Francesco-Pagano/Agrometeorological-Station/v1_Pi4/img/Prototype.jpg

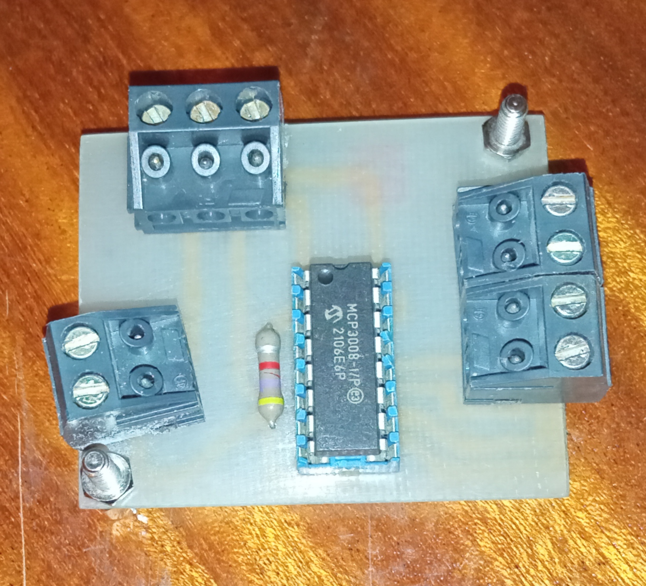
v1_Pi4/img/Prototype.jpg
