Francesco-Pagano/Agrometeorological-Station/v2_Pi0/img/Prototype.jpg

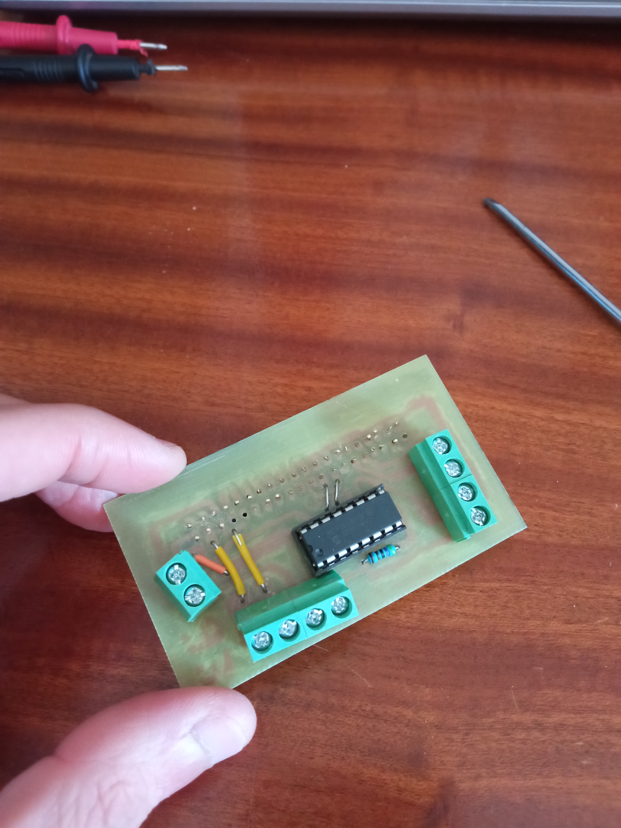
v2_Pi0/img/Prototype.jpg
