Francesco-Pagano/Agrometeorological-Station/v3_Heltec_v2/img/Power.png

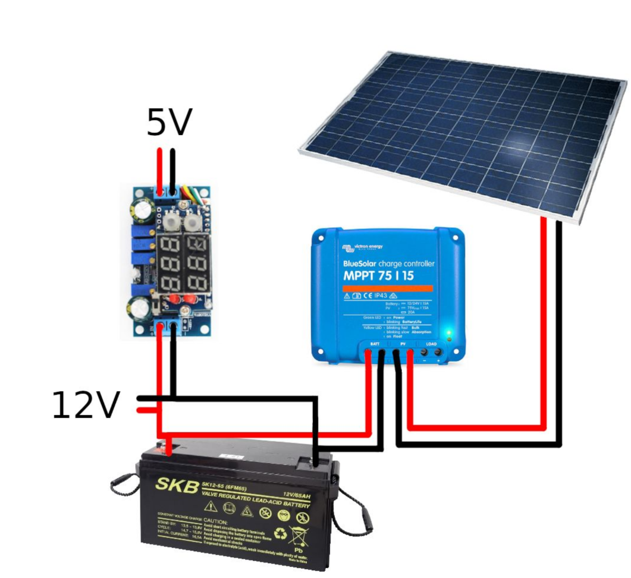
v3_Heltec_v2/img/Power.png
