Francesco-Pagano/Agrometeorological-Station/v4_ESP8266/Schematic_ESP8266_WS.pdf

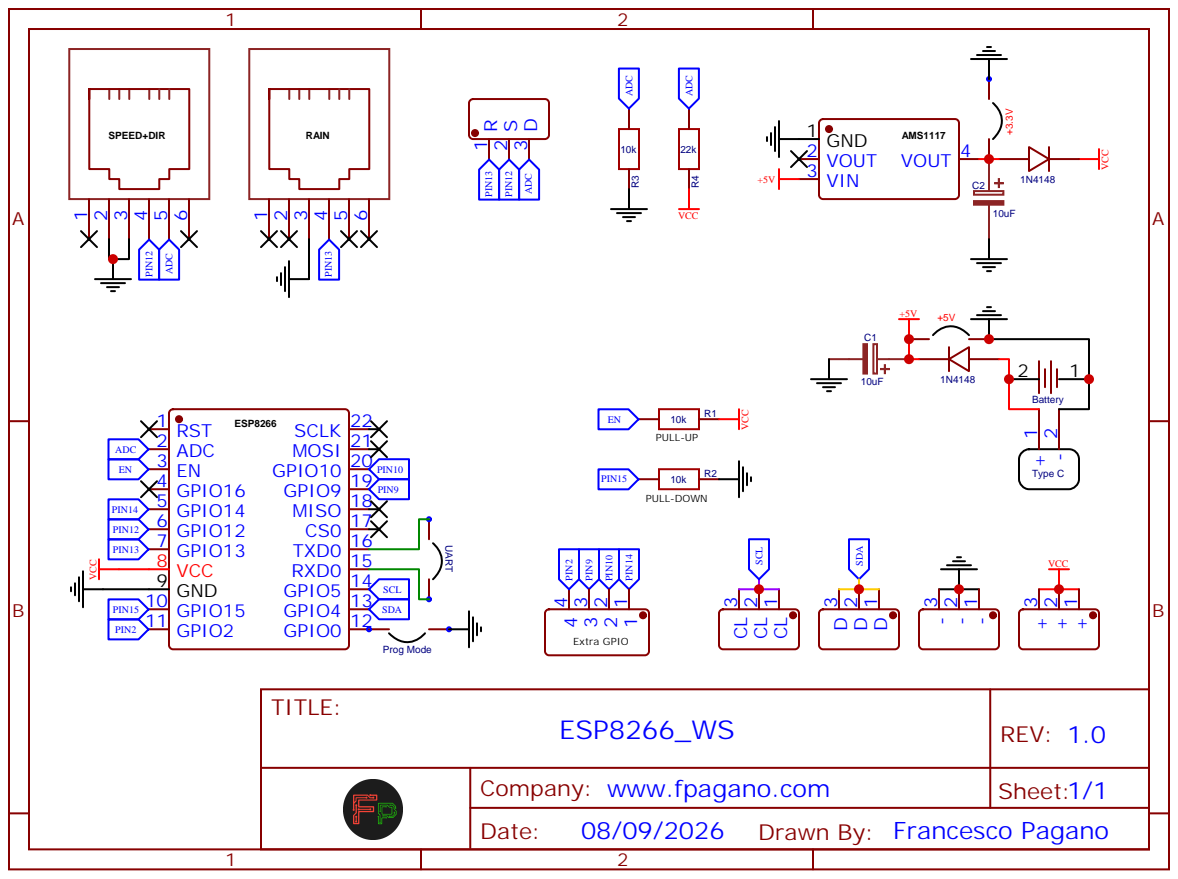
[picture p17: page 1]

Company: www.fpagano.com
