Francesco-Pagano/Agrometeorological-Station/v1_Pi4/Schematic_ShieldPi4_WS.pdf

# CH7 8 ⁵V

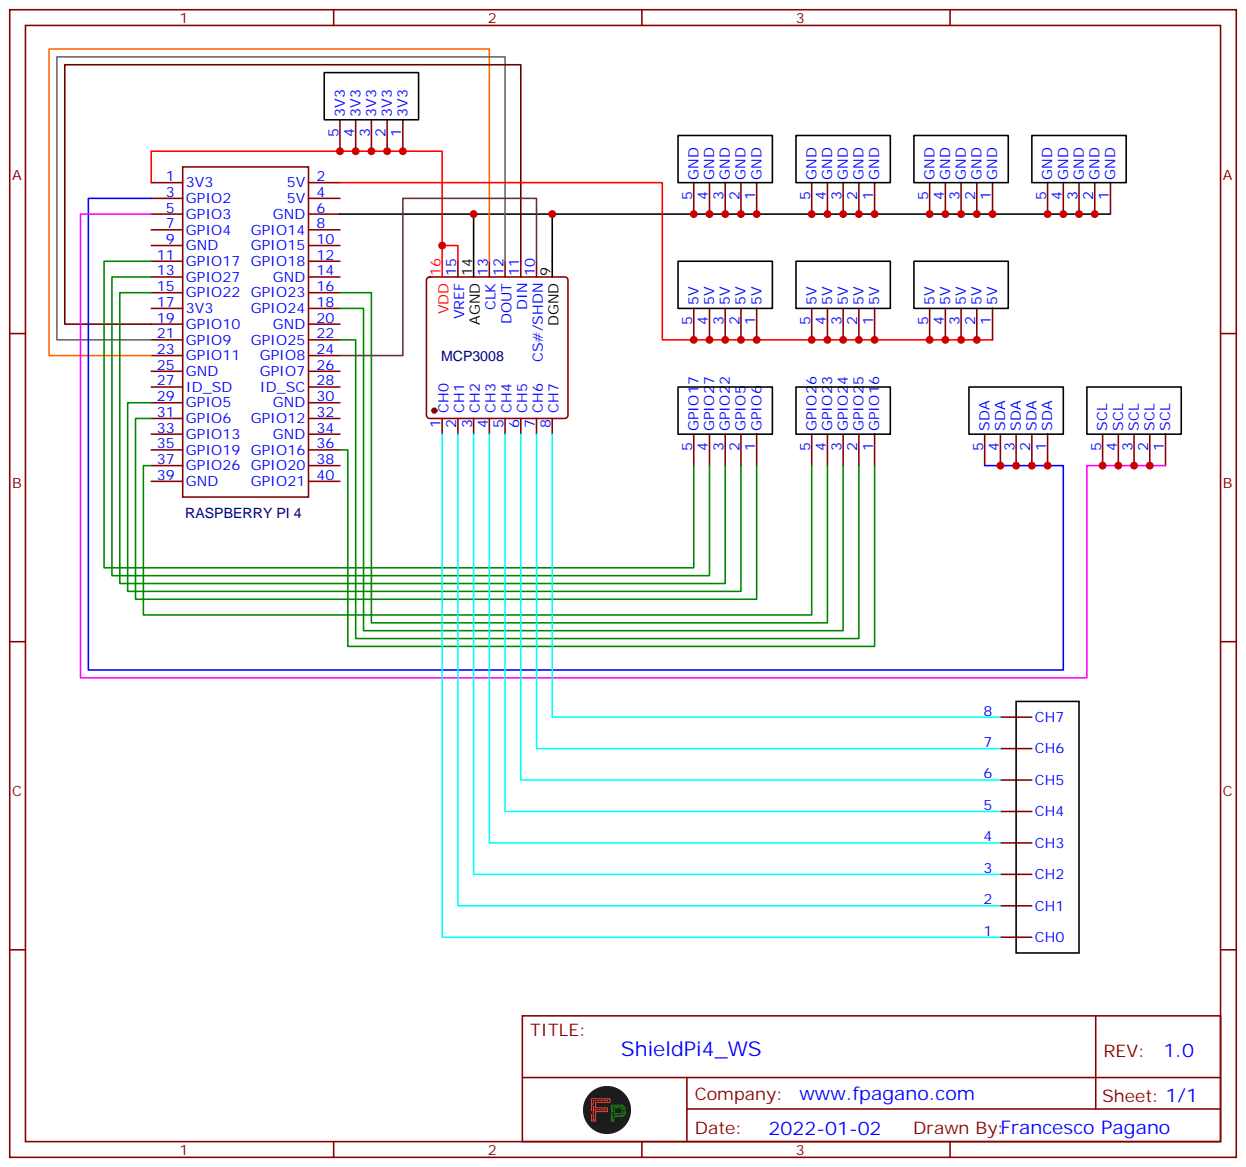
[picture p18: page 1]

9 CS#/SHDN 10 DIN 11 DOUT 12 CLK 13 AGND 14 VREF 15 VDD 16

Company: www.fpagano.com
