Francesco-Pagano/Agrometeorological-Station/v3_Heltec_v2/Schematic_ShieldHeltec_WS.pdf

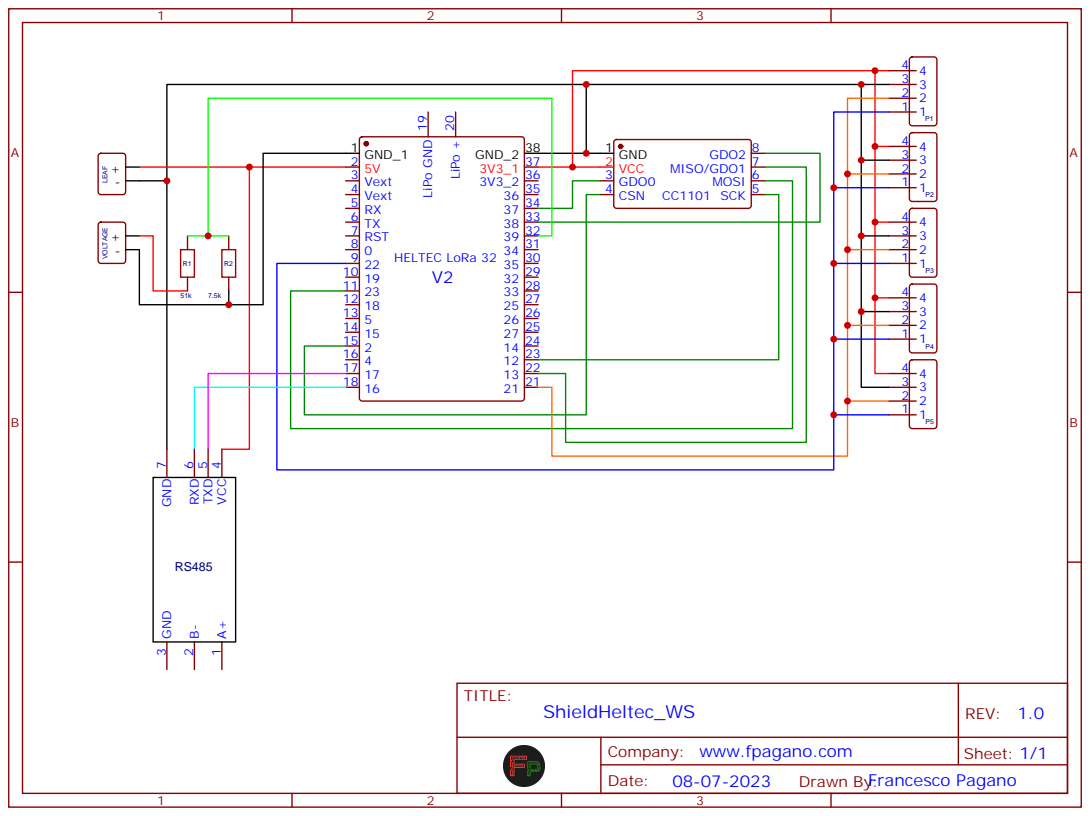
[picture p19: page 1]

Company: www.fpagano.com
