Francesco-Pagano/Agrometeorological-Station/v1_Pi4/PCB_PCB_ShieldPi4_WS.pdf

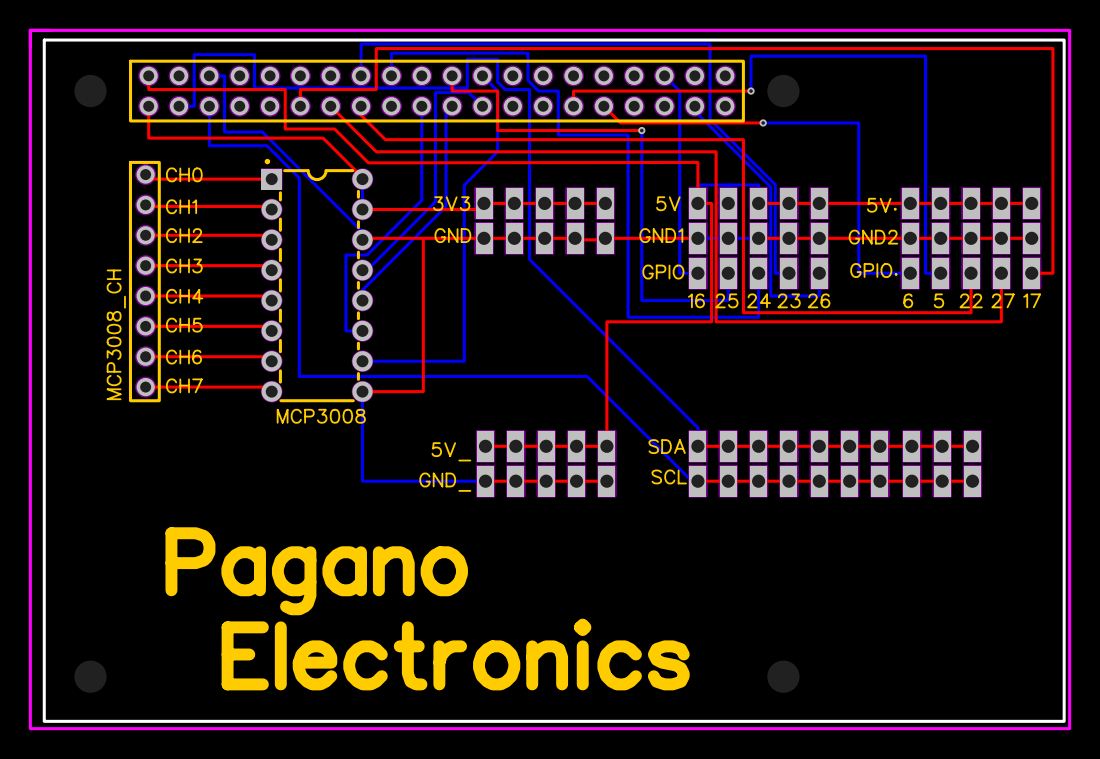
[picture p20: page 1]
