Francesco-Pagano/Agrometeorological-Station/v2_Pi0/PCB_PCB_ShieldPi0_WS.pdf

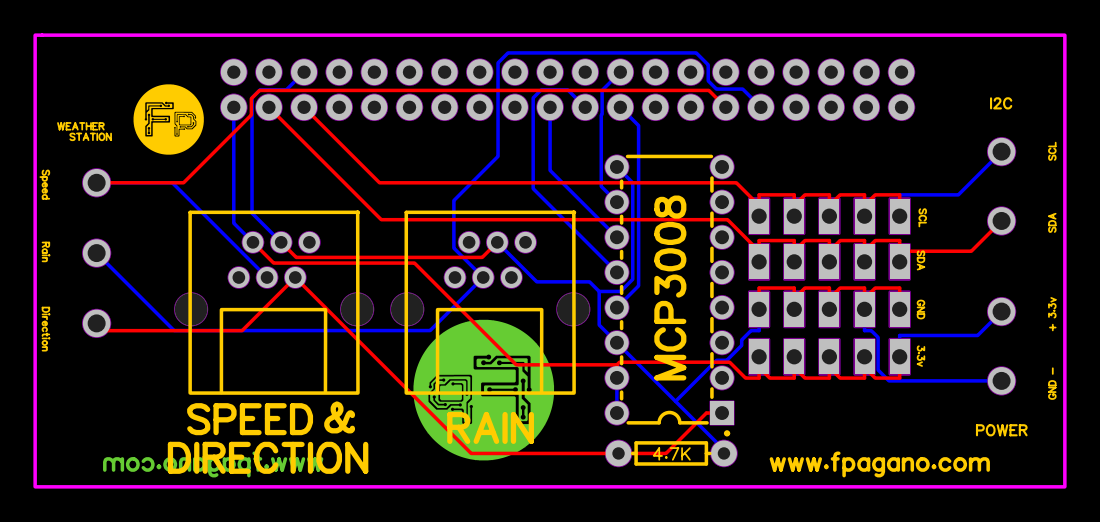
[picture p21: page 1]
