Francesco-Pagano/Agrometeorological-Station/v3_Heltec_v2/PCB_PCB_ShieldHeltec_WS.pdf

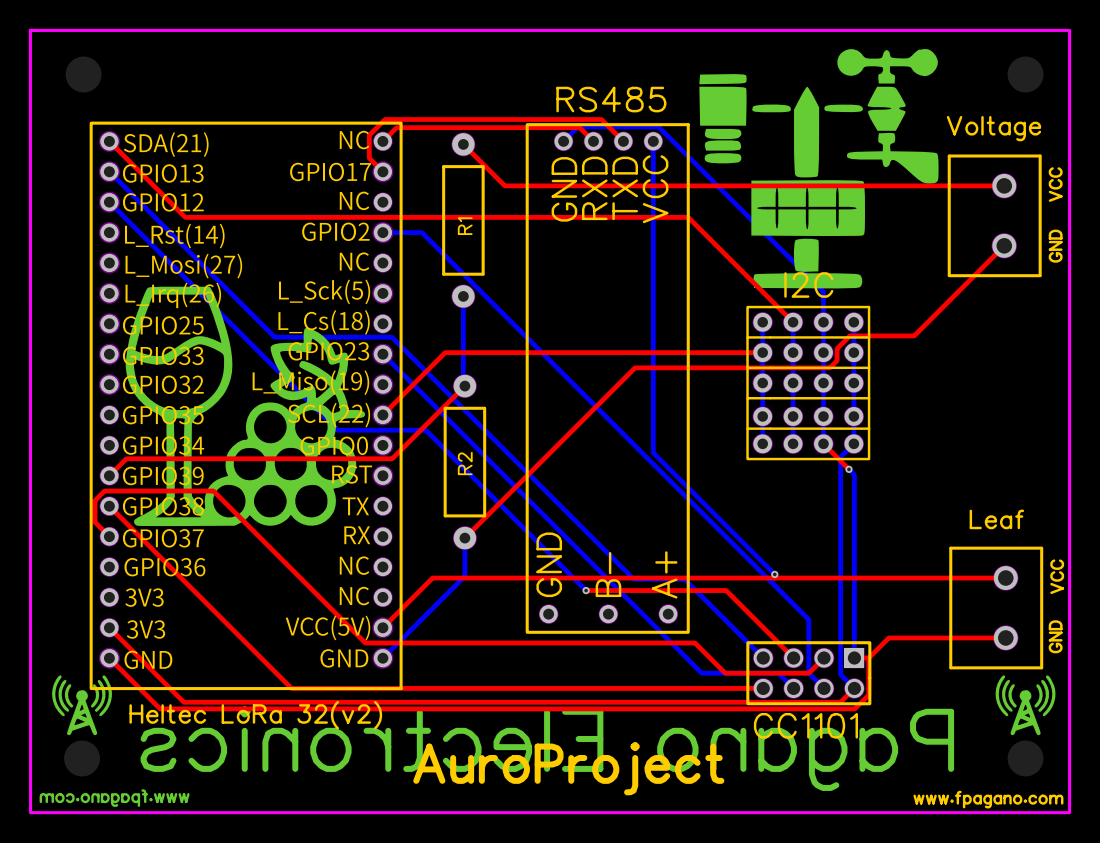
[picture p22: page 1]
