Francesco-Pagano/Agrometeorological-Station/(list of files, drawings)

Other design files:
v1_Pi4/EasyEDA_Files/PCB_ShieldPi4_WS.json
v1_Pi4/EasyEDA_Files/ShieldPi4_WS.json
v2_Pi0/EasyEDA_Files/PCB_ShieldPi0_WS.json
v2_Pi0/EasyEDA_Files/ShieldPi0_WS.json
v3_Heltec_v2/EasyEDA_Files/PCB_ShieldHeltec_WS.json
v3_Heltec_v2/EasyEDA_Files/ShieldHeltec_WS.json
v4_ESP8266/EasyEDA_Files/ESP8266_WS.json
