Francesco-Pagano/Agrometeorological-Station/v4_ESP8266/code/include/rain_sensor.h

#pragma once
#include <Arduino.h>

// Configura il pin e l'interrupt del pluviometro. Da chiamare in setup().
void rainSensorBegin();

// Legge i click accumulati dall'ultima chiamata, azzera il contatore,
// e restituisce i millimetri di pioggia corrispondenti.
float readAndResetRainMM();
