Francesco-Pagano/Agrometeorological-Station/v5_Heltec_v3/code/RX_Heltec/src/secrets_template.h

#include <Arduino.h>

const char* WIFI_SSID     = "TUO_WIFI_SSID";
const char* WIFI_PASSWORD = "TUO_WIFI_PASSWORD";

#define OTA_HOSTNAME "TUO_OTA_HOSTNAME"
#define OTA_PASSWORD "TUO_OTA_PASSWORD"

#define MQTT_SERVER "TUO_MQTT_SERVER"
#define MQTT_PORT TUA_PORTA_MQTT
const char* mqtt_topic = "TUO_MQTT_TOPIC";
const char* mqtt_topic_status = "TUO_MQTT_TOPIC_STATUS";
const char* mqtt_clientName = "TUO_MQTT_CLIENT_NAME";

#define OTA_VERSION_URL "http://TUO_OTA_URL/version.txt"
#define OTA_FIRMWARE_URL "http://TUO_FIRMWARE_URL/NOME_FIRMWARE.bin"
