Francesco-Pagano/Agrometeorological-Station/v5_Heltec_v3/code/TX_Heltec/src/secrets_template.h

#include <Arduino.h>

const char* WIFI_SSID     = "TUO_WIFI_SSID";
const char* WIFI_PASSWORD = "TUO_WIFI_PASSWORD";

const char* OTA_HOSTNAME  = "TUO_OTA_HOSTNAME";
const char* OTA_PASSWORD  = "TUO_OTA_PASSWORD";
