Francesco-Pagano/Agrometeorological-Station/v4_ESP8266/code/src/ota_manager.cpp

#include "ota_manager.h"
#include "config.h"
#include <ArduinoOTA.h>

void otaBegin() {
  ArduinoOTA.setHostname(OTA_HOSTNAME);
  ArduinoOTA.setPassword(OTA_PASSWORD);
  ArduinoOTA.begin();
}

void otaHandle() {
  ArduinoOTA.handle();
}
