Francesco-Pagano/Agrometeorological-Station/(commit log)

2026-09-09 Fix v4
    [ESP8266_WS.json]
2026-10-06 Rename v* and add v5_Heltec_v3
    [ESP8266_WS.json, PCB_ShieldHeltec_WS.json, PCB_ShieldPi0_WS.json, PCB_ShieldPi4_WS.json, ShieldHeltec_WS.json, ShieldPi0_WS.json, ShieldPi4_WS.json]
2026-10-06 Fix radio.begin + add topic_status v5_Heltec_v3 RX
    [main.cpp, secrets_template.h]
